mechatronery/scibee/SCIBee_Base/SCIBee_Base_Control_Board/SCIBee_Base_Control_Board_mount/RASPBERRY_PI_5_WITH_ACTIVE_COOLER.stl

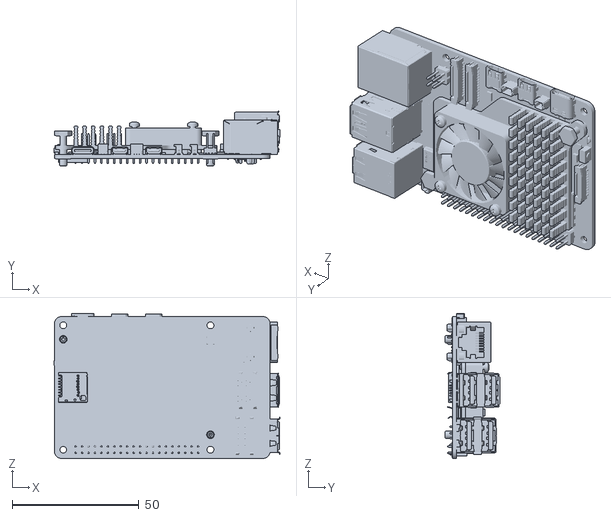
[picture p2: CAD file, 2026-10-22]
SCIBee_Base/SCIBee_Base_Control_Board/SCIBee_Base_Control_Board_mount/RASPBERRY_PI_5_WITH_ACTIVE_COOLER.stl
89.0 x 21.6 x 57.2
