mechatronery/scibee/SCIBee_Entrance/SCIBee_Entrance_Hardware/scibee_entrance_hardware.FCStd

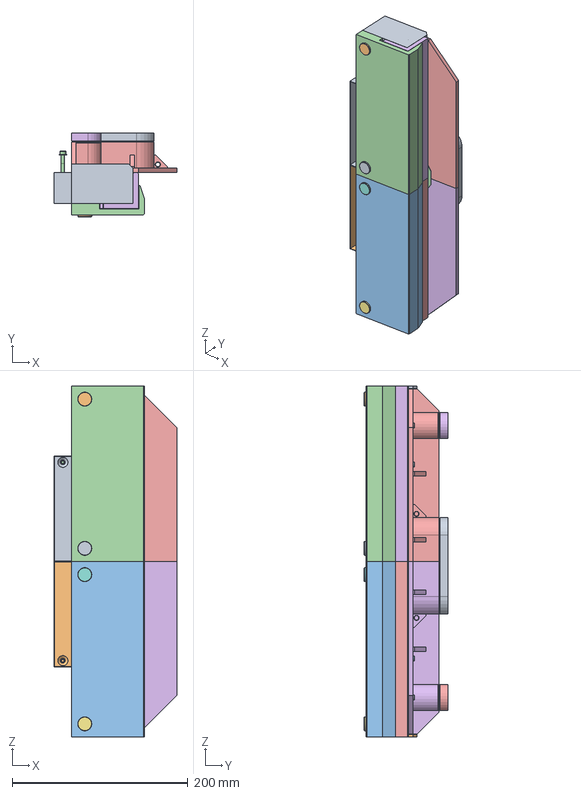
[picture p3: CAD file, 2026-10-22]
SCIBee_Entrance/SCIBee_Entrance_Hardware/scibee_entrance_hardware.FCStd
140.0 x 95.4 x 400.0 mm
Main_slice_0 x 2
Main_slice_1 x 2
Top_slice_0 x 2
Top_slice_1 x 2
Bot_slice_0 x 2
Bot_slice_1 x 2
Board
HSOP8
0805-NO
PANASONIC_D
0805-THM
Board001
HSOP009
0805-NO001
PANASONIC_D001
0805-THM001
M3x8-Screw340
M3x8-Screw342
M3x8-Screw343
M3-Washer311
M3x8-Screw344
M3-Washer312
M3x8-Screw345
M3-Washer313
M3x8-Screw339
M3-Washer309
M3-Nut
M3-Nut054
M3x8-Screw346
M3-Washer314
M3x8-Screw341
M3-Washer310
M3x8-Screw347
M3-Washer315
M3x8-Screw348
M3-Washer316
M3x8-Screw
M3-Washer
M3x8-Screw349
M3-Washer317
M3x8-Screw350
M3-Washer318
M3x8-Screw351
M3-Washer319
M3x8-Screw352
M3-Washer320
M3x8-Screw353
M3-Washer321
M3x8-Screw354
M3-Washer322
M3x8-Screw338
M3-Washer308
M3x8-Screw355
M3-Washer323
M3x8-Screw356
M3-Washer324
M3x16-Screw
M3x16-Screw005
M3-Nut055
M3-Nut056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
