mechatronery/scibee/SCIBee_Base/SCIBee_Base_Control_Board/SCIBee_Base_Control_Board_mount/models/MountingPlate_edge.stl

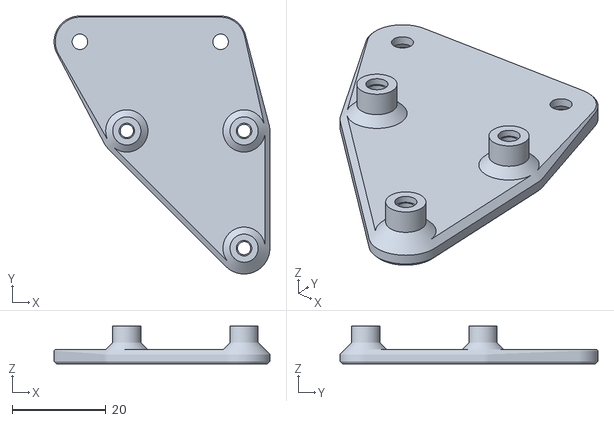
[picture p4: CAD file, 2026-10-22]
SCIBee_Base/SCIBee_Base_Control_Board/SCIBee_Base_Control_Board_mount/models/MountingPlate_edge.stl
46.0 x 55.0 x 8.00
