mechatronery/scibee/SCIBee_Base/SCIBee_Base_Control_Board/SCIBee_Base_Control_Board_mount/models/MountingPlate_powermeter.stl

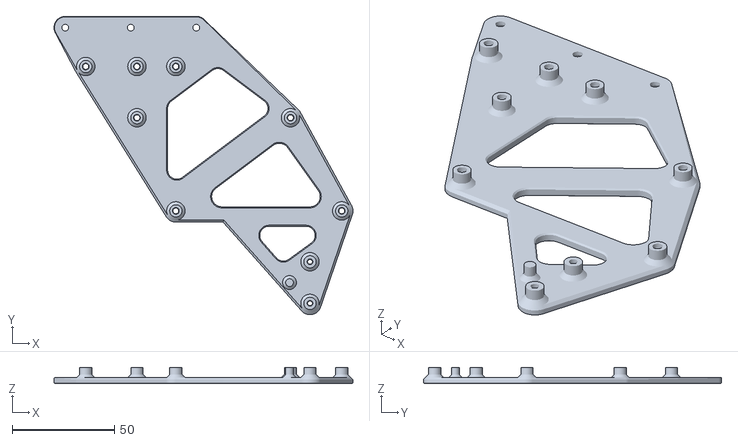
[picture p5: CAD file, 2026-10-22]
SCIBee_Base/SCIBee_Base_Control_Board/SCIBee_Base_Control_Board_mount/models/MountingPlate_powermeter.stl
146.0 x 145.7 x 8.00
