mechatronery/scibee/SCIBee_Base/SCIBee_Base_Control_Board/SCIBee_Base_Control_Board_mount/raspberry pi zero 2 w.stl

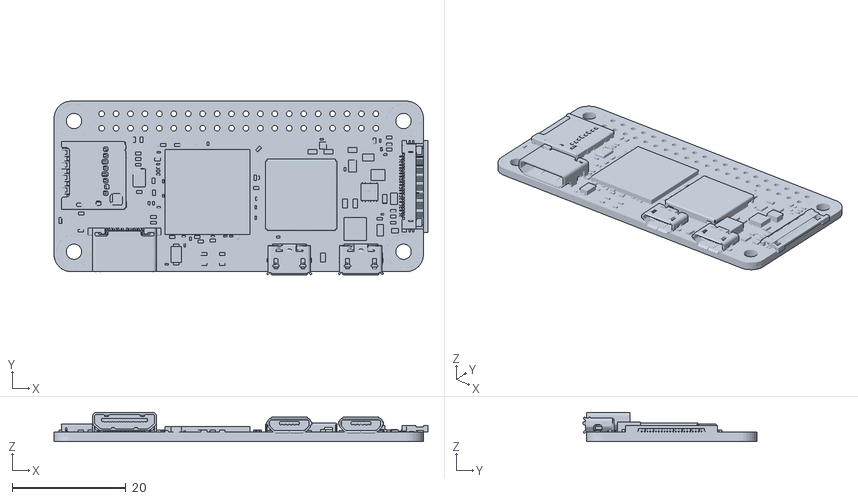
[picture p6: CAD file, 2026-10-22]
SCIBee_Base/SCIBee_Base_Control_Board/SCIBee_Base_Control_Board_mount/raspberry pi zero 2 w.stl
65.8 x 30.6 x 5.11
