mechatronery/scibee/SCIBee_Base/SCIBee_Base_Control_Board/SCIBee_Base_Control_Board_mount/models/Pump_adapter_tool.stl

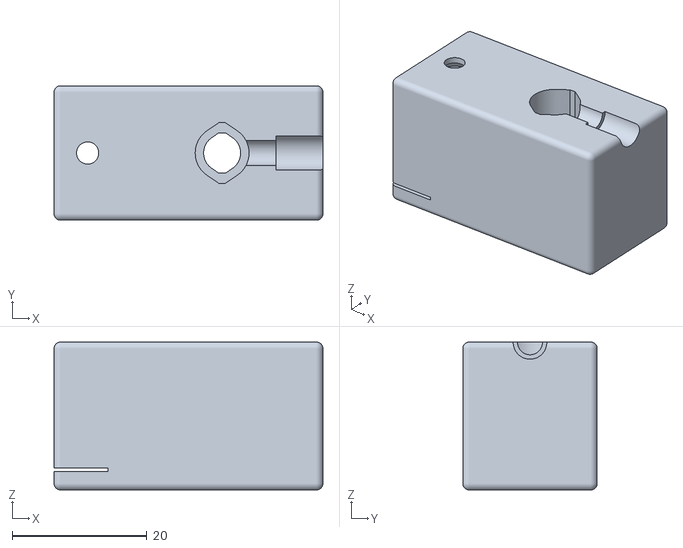
[picture p7: CAD file, 2026-10-22]
SCIBee_Base/SCIBee_Base_Control_Board/SCIBee_Base_Control_Board_mount/models/Pump_adapter_tool.stl
40.0 x 20.0 x 22.0
