mechatronery/scibee/SCIBee_Base/SCIBee_Base_Control_Board/SCIBee_Base_Control_Board_mount/models/MountingPlate_RPi_edge.stl

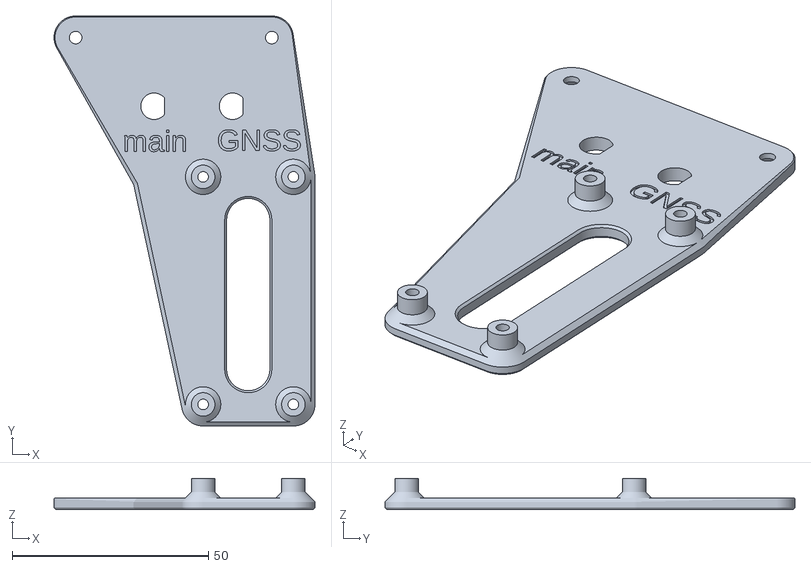
[picture p8: CAD file, 2026-10-22]
SCIBee_Base/SCIBee_Base_Control_Board/SCIBee_Base_Control_Board_mount/models/MountingPlate_RPi_edge.stl
66.5 x 104.5 x 8.00
