mechatronery/scibee/SCIBee_Base/SCIBee_Base_Control_Board/SCIBee_Base_Control_Board_mount/models/MountingPlate_RPi.stl

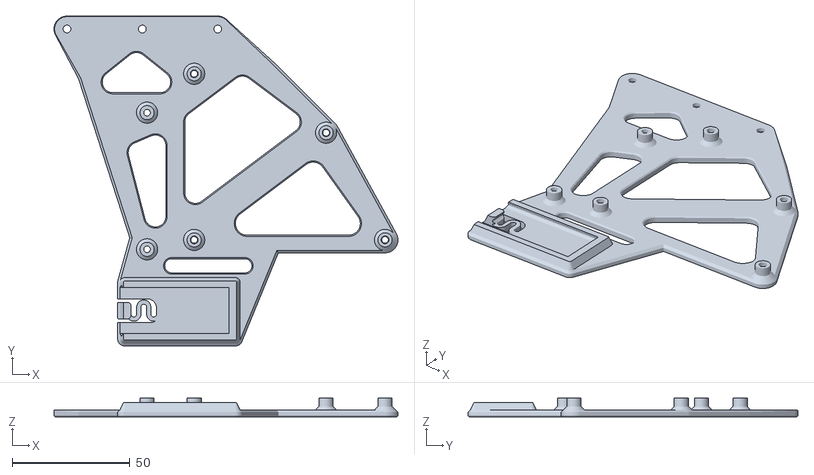
[picture p9: CAD file, 2026-10-22]
SCIBee_Base/SCIBee_Base_Control_Board/SCIBee_Base_Control_Board_mount/models/MountingPlate_RPi.stl
146.0 x 140.0 x 8.00
