mechatronery/scibee/SCIBee_Base/SCIBee_Base_Control_Board/SCIBee_Base_Control_Board_mount/models/PumpAdapter_MZB3004T04_top.stl

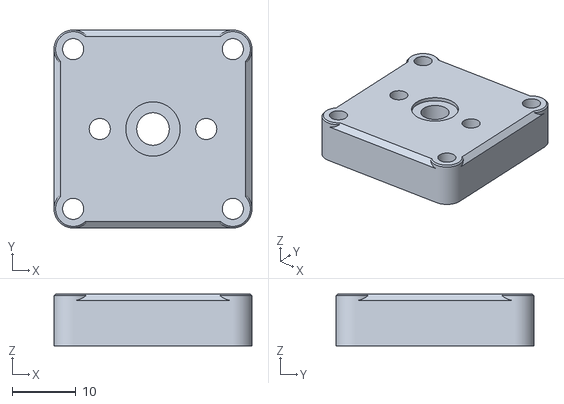
[picture p11: CAD file, 2026-10-22]
SCIBee_Base/SCIBee_Base_Control_Board/SCIBee_Base_Control_Board_mount/models/PumpAdapter_MZB3004T04_top.stl
31.0 x 31.0 x 8.10
