mechatronery/scibee/SCIBee_Base/SCIBee_Base_Control_Board/SCIBee_Base_Control_Board_mount/models/PumpAdapter_MZB3004T04_cap.stl

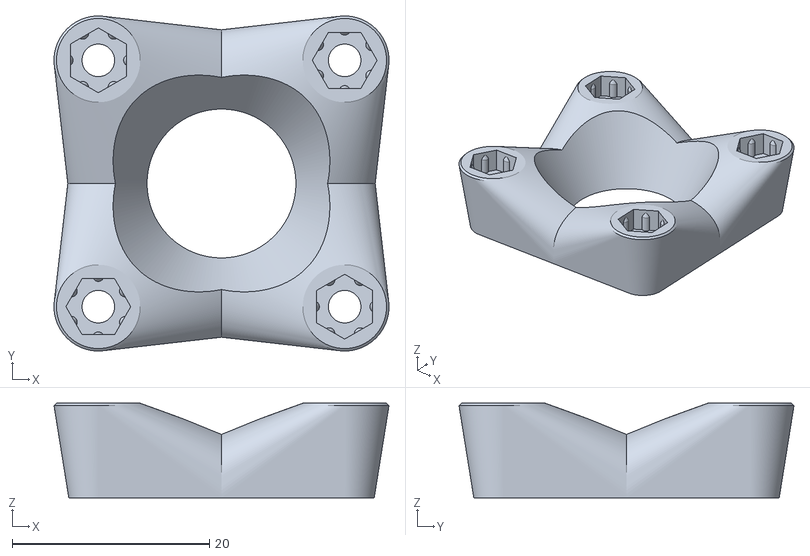
[picture p12: CAD file, 2026-10-22]
SCIBee_Base/SCIBee_Base_Control_Board/SCIBee_Base_Control_Board_mount/models/PumpAdapter_MZB3004T04_cap.stl
34.0 x 34.0 x 9.60
