mechatronery/scibee/SCIBee_Base/SCIBee_Base_Control_Board/SCIBee_Base_Control_Board_mount/models/PumpAdapter_MZB3004T04_2pump-connecting.stl

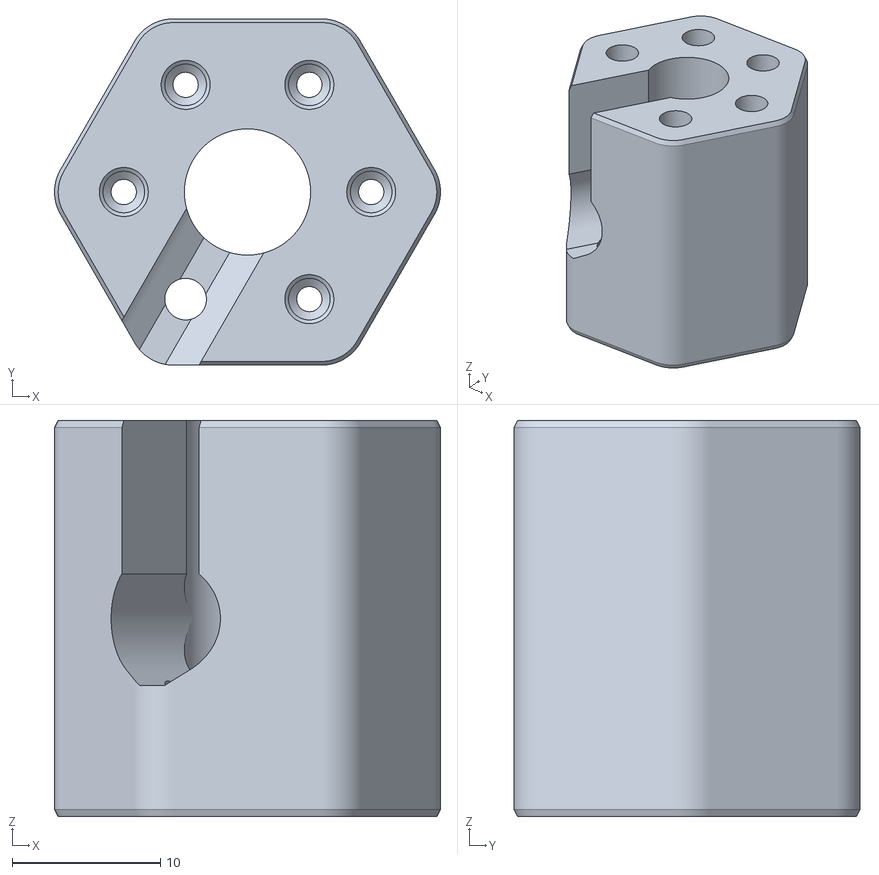
[picture p13: CAD file, 2026-10-22]
SCIBee_Base/SCIBee_Base_Control_Board/SCIBee_Base_Control_Board_mount/models/PumpAdapter_MZB3004T04_2pump-connecting.stl
26.0 x 23.3 x 26.7
