mechatronery/scibee/(list of files, cad)

Other CAD files:
SCIBee_Base/SCIBee_Base_Stand/scibee_base_stand.step
SCIBee_Base/SCIBee_Base_Control_Board/SCIBee_Base_Control_Board_mount/SCIBee_v1.11B.stl
SCIBee_Base/SCIBee_Base_Stand/scibee_base_stand.FCStd
