mechatronery/scibee/SCIBee_Base/SCIBee_Base_Stand/scibee_base_stand_parts.pdf

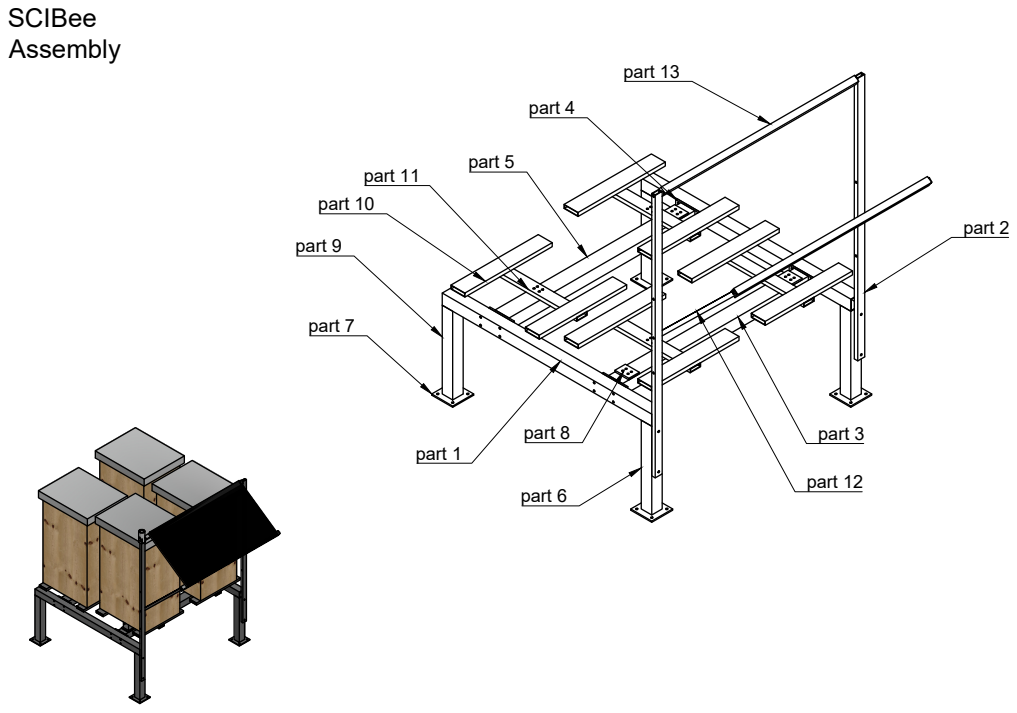
[picture p15: page 1]
part 1; part 2; part 3; part 4; part 5; part 6; part 7; part 8; part 9; part 10; part 11; part 12; part 13

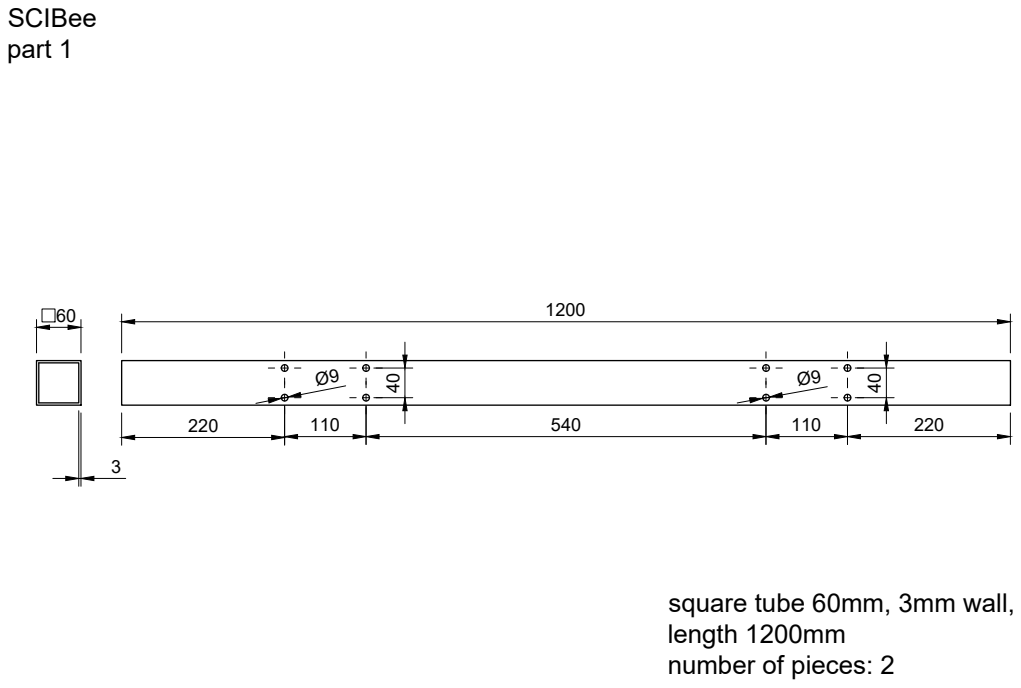
[picture p16: page 2]
part 1

square tube 60mm, 3mm wall,
length 1200mm
number of pieces: 2

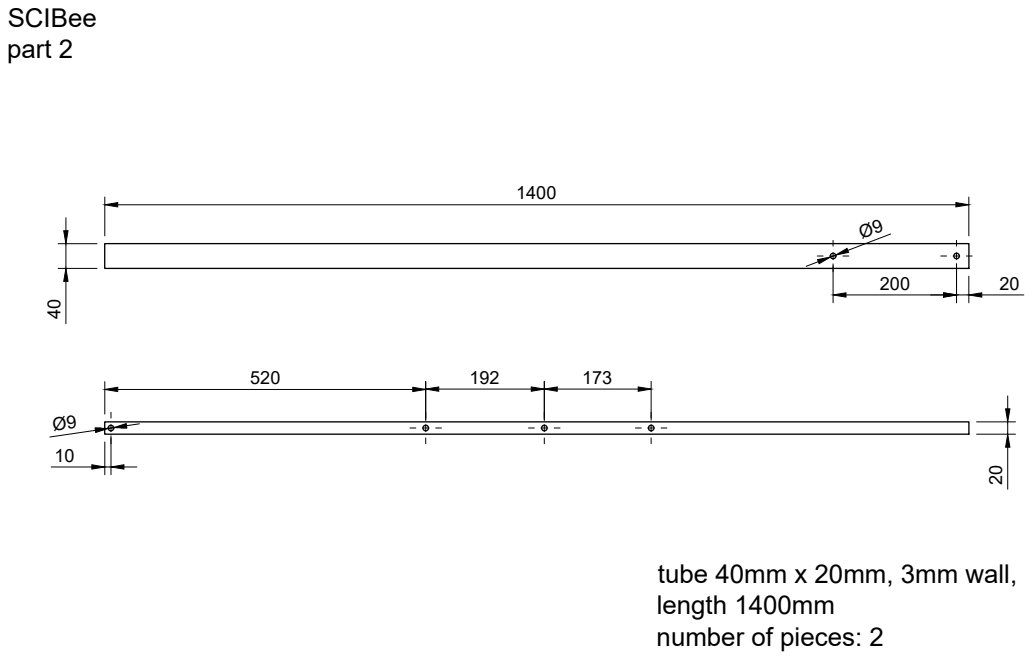
[picture p17: page 3]
part 2

tube 40mm x 20mm, 3mm wall,
length 1400mm
number of pieces: 2

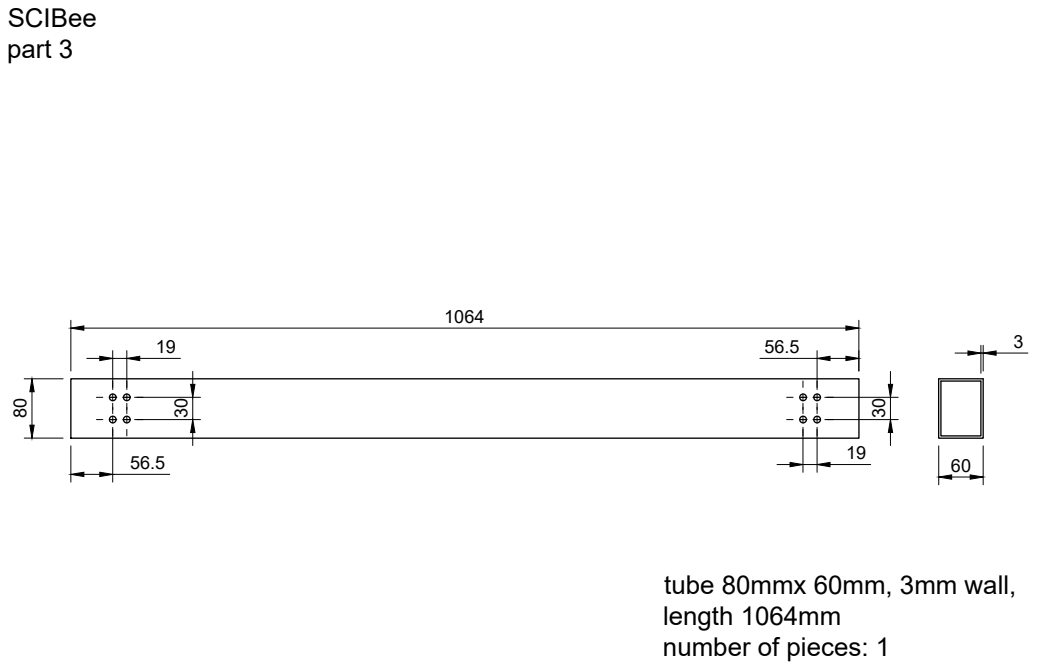
[picture p18: page 4]
part 3

tube 80mmx 60mm, 3mm wall,
length 1064mm
number of pieces: 1

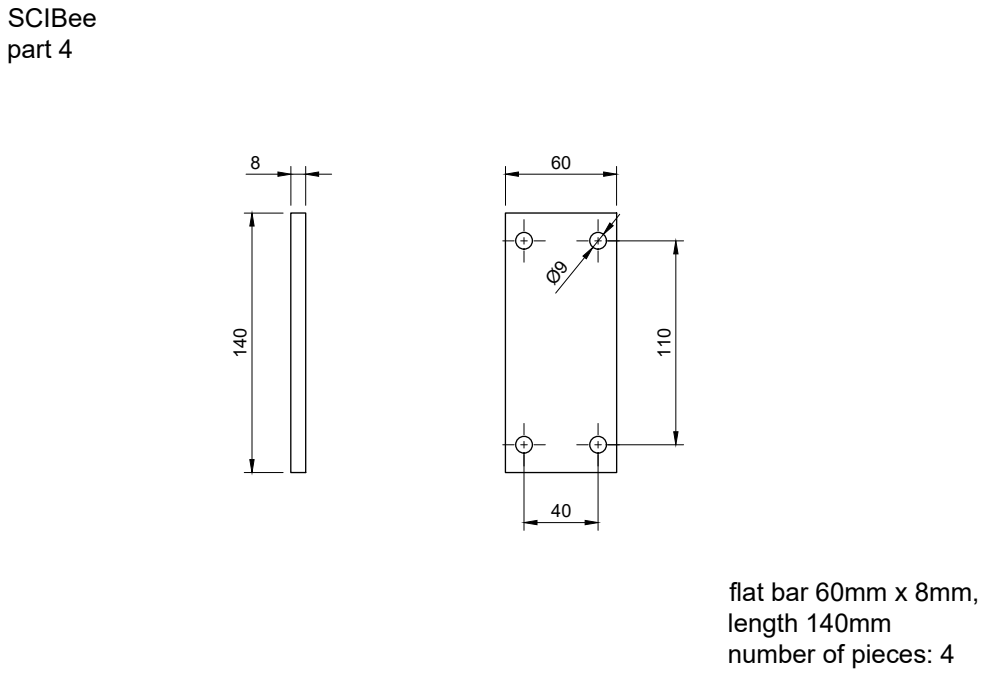
[picture p19: page 5]
flat bar 60mm x 8mm, length 140mm; part 4

number of pieces: 4 140

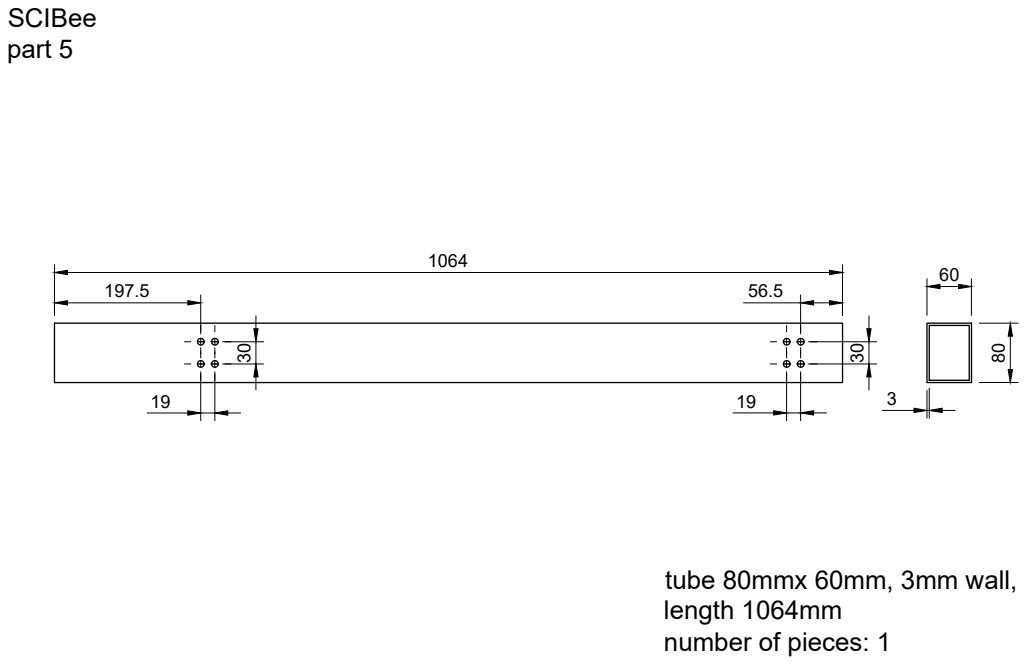
[picture p20: page 6]
part 5

tube 80mmx 60mm, 3mm wall,
length 1064mm
number of pieces: 1

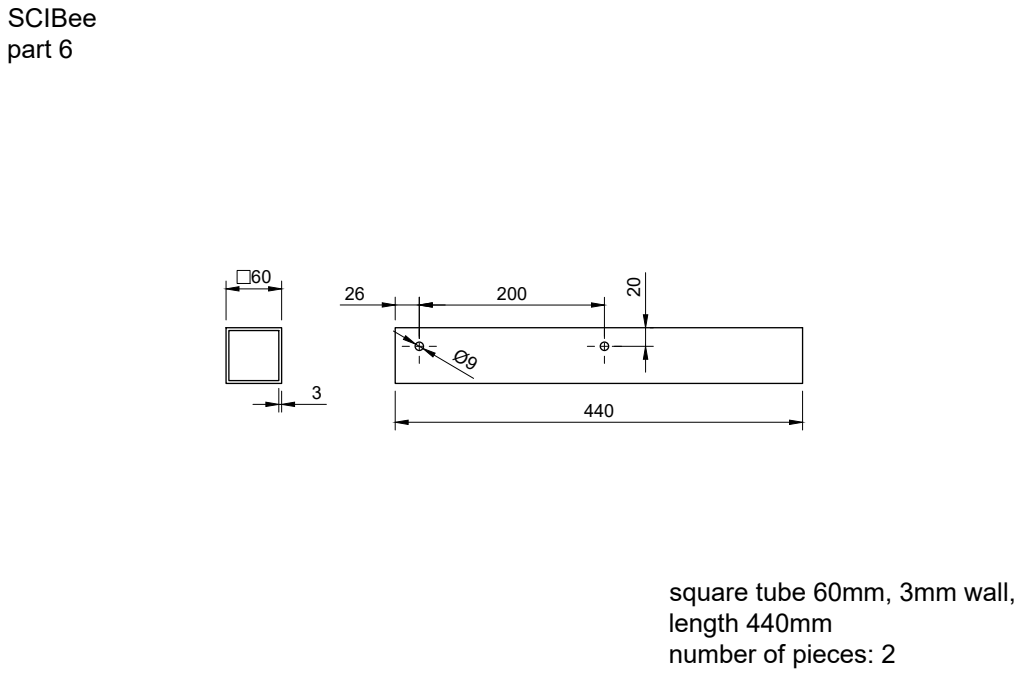
[picture p21: page 7]
part 6

square tube 60mm, 3mm wall,
length 440mm
number of pieces: 2

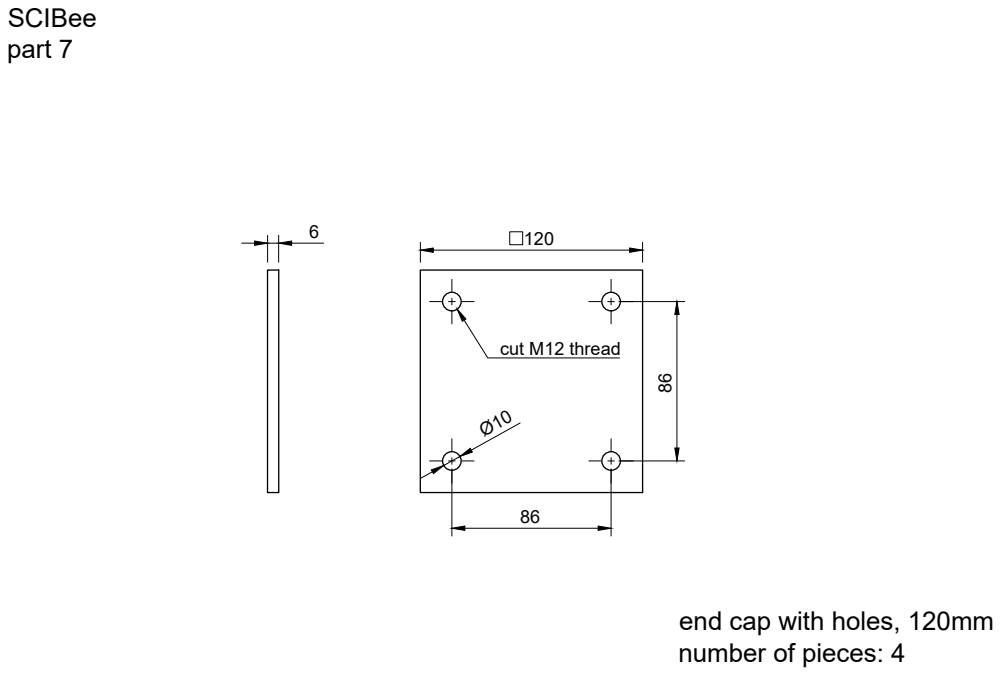
[picture p22: page 8]
cut M12 thread; part 7

end cap with holes, 120mm
number of pieces: 4

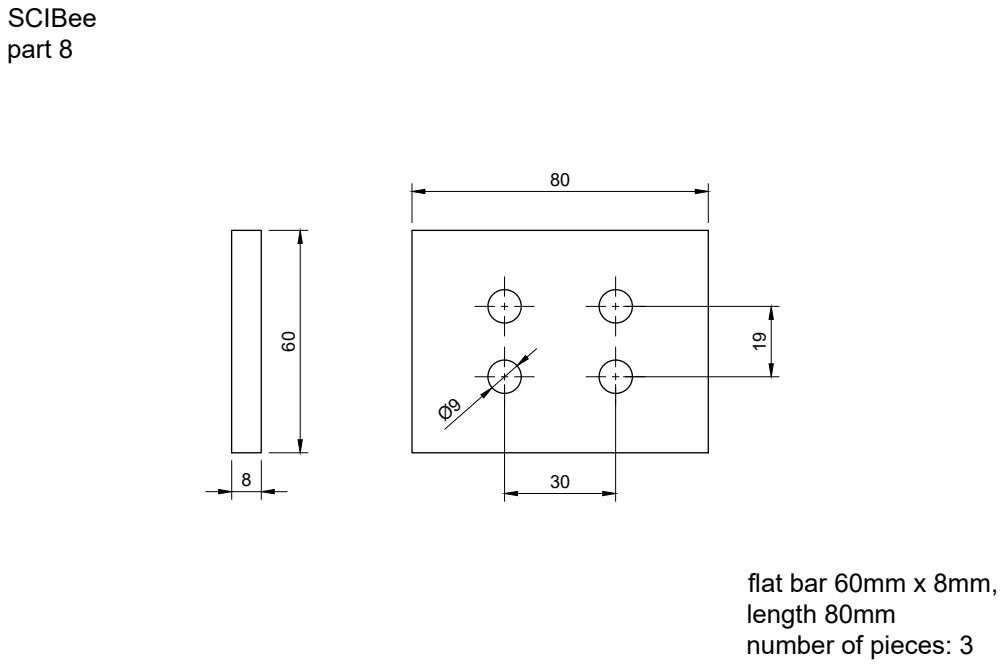
[picture p23: page 9]
flat bar 60mm x 8mm, length 80mm; part 8

number of pieces: 3 60

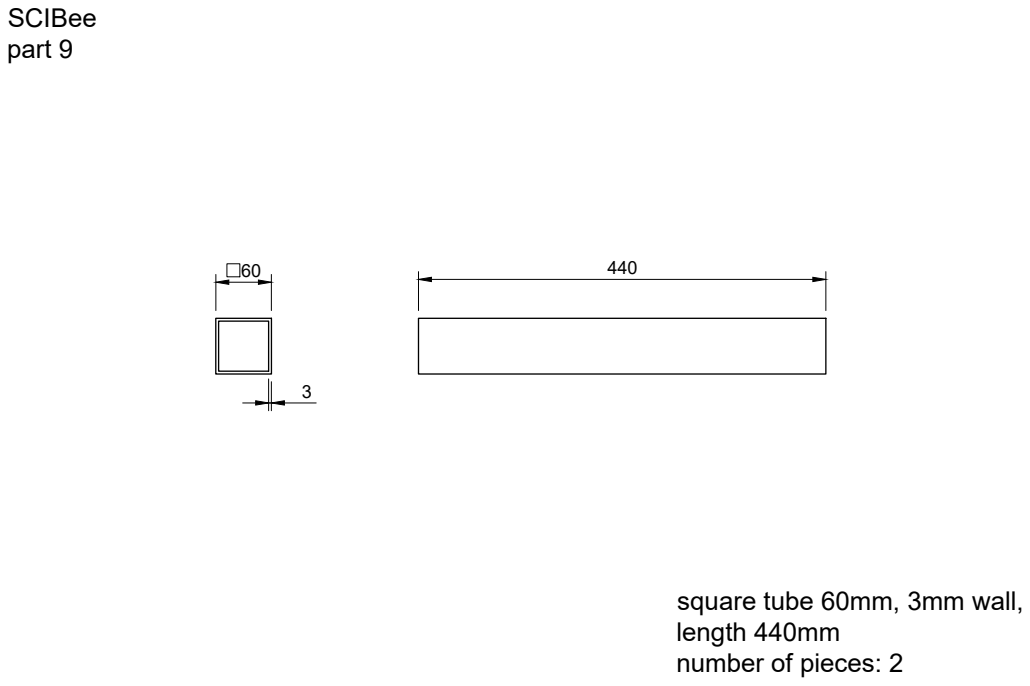
[picture p24: page 10]
part 9

square tube 60mm, 3mm wall,
length 440mm
number of pieces: 2

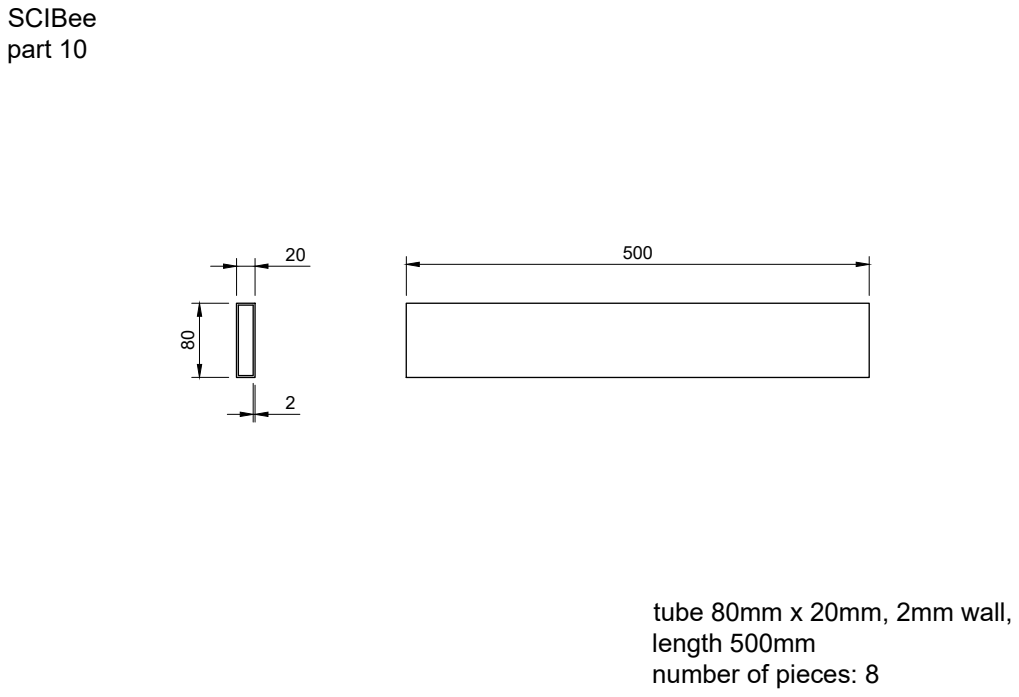
[picture p25: page 11]
tube 80mm x 20mm, 2mm wall, length 500mm; part 10

number of pieces: 8 80

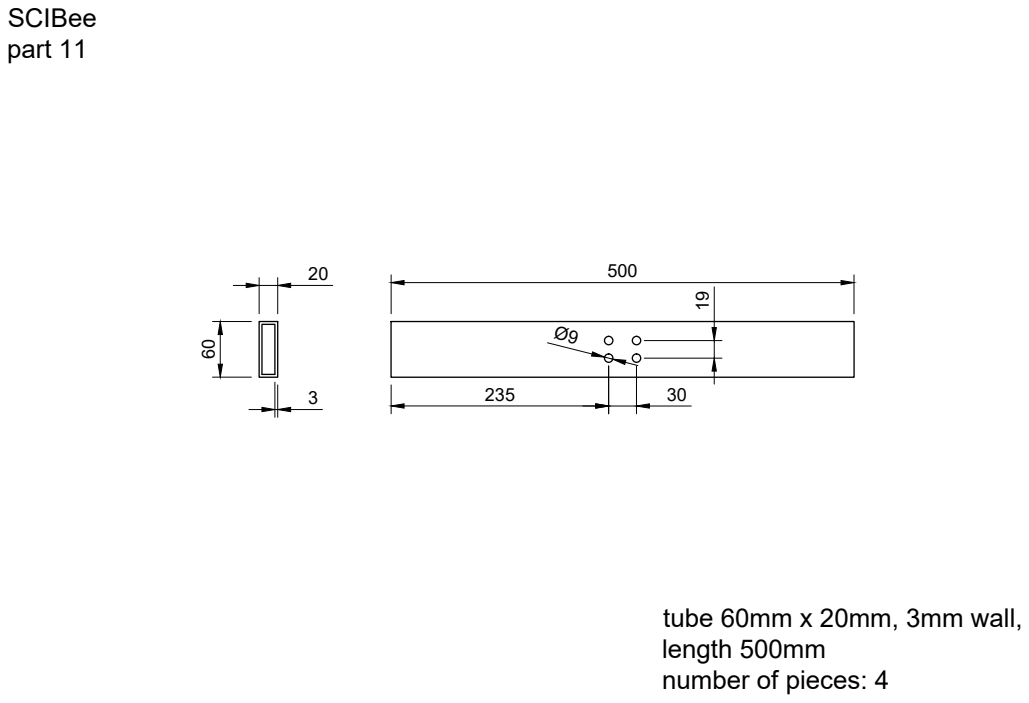
[picture p26: page 12]
tube 60mm x 20mm, 3mm wall, length 500mm; part 11

number of pieces: 4 60

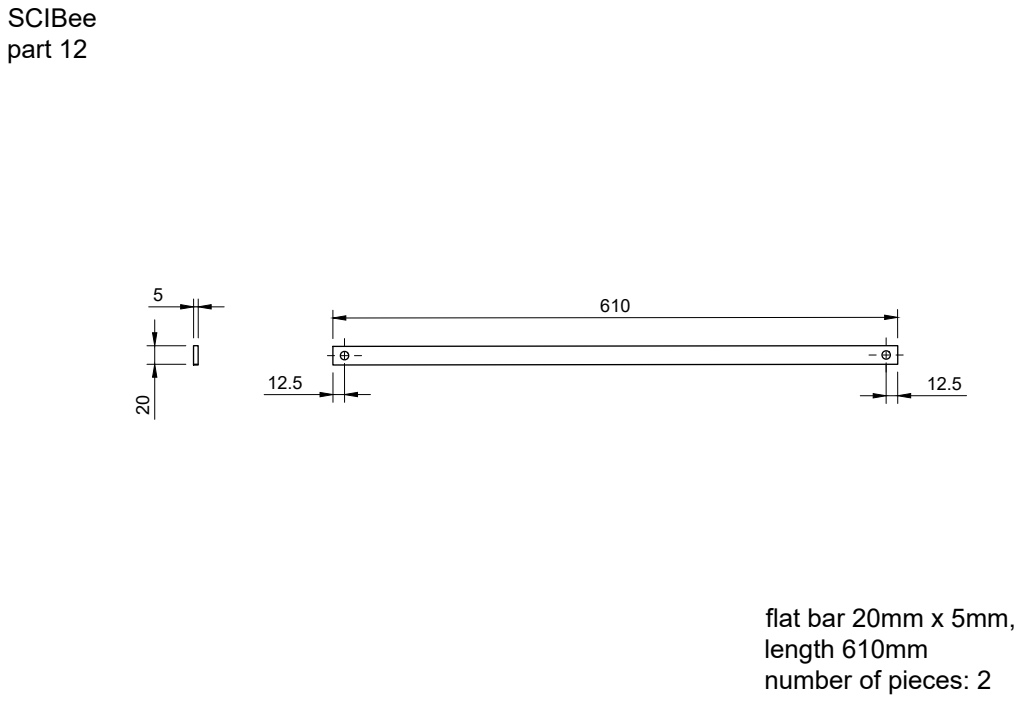
[picture p27: page 13]
part 12

flat bar 20mm x 5mm,
length 610mm
number of pieces: 2

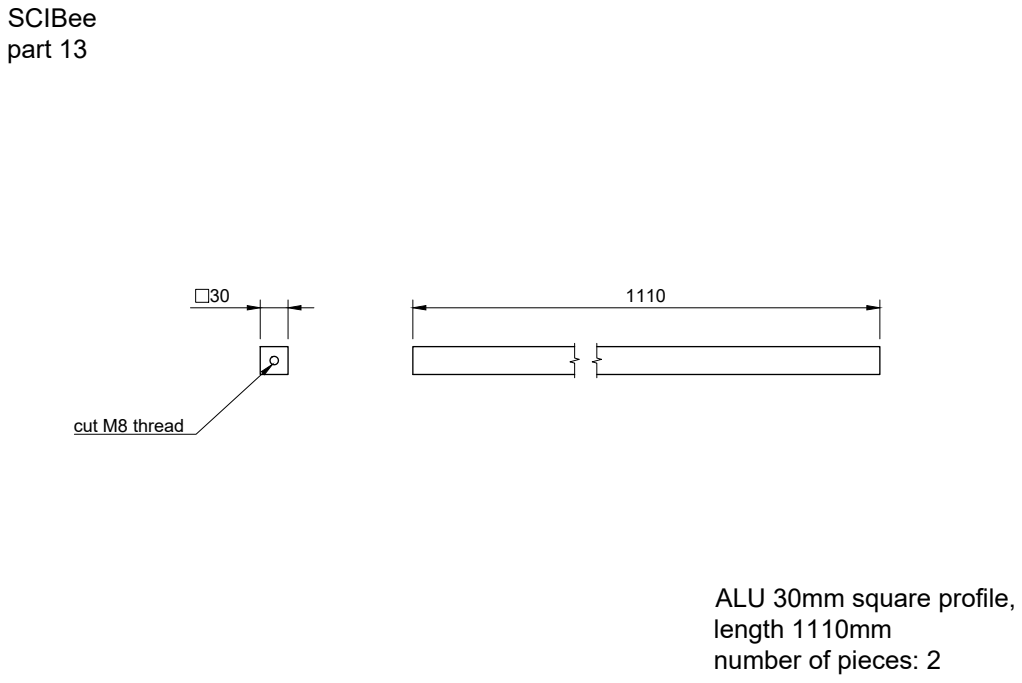
[picture p28: page 14]
cut M8 thread; part 13

ALU 30mm square profile,
length 1110mm
number of pieces: 2

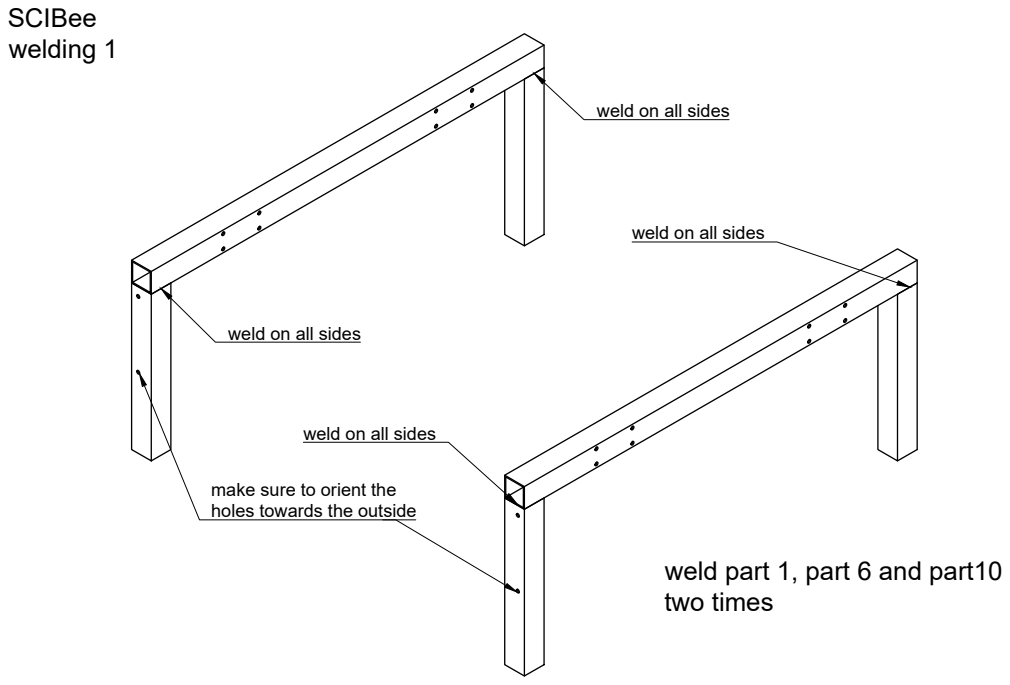
[picture p29: page 15]
welding 1

weld on all sides

make sure to orient the
holes towards the outside

weld part 1, part 6 and part10
two times

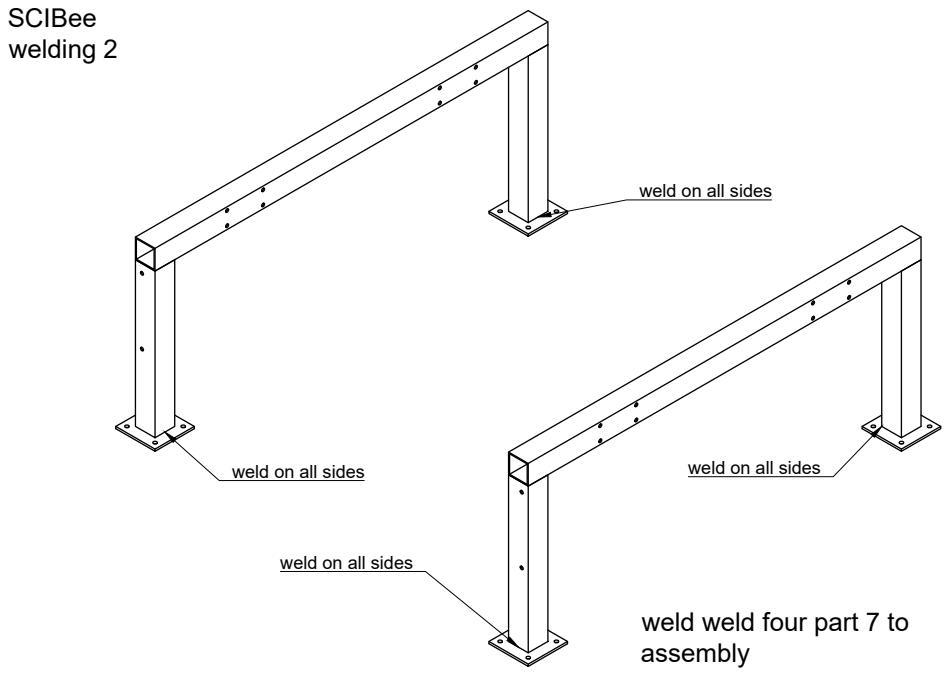
[picture p30: page 16]
welding 2

weld on all sides

weld weld four part 7 to
assembly

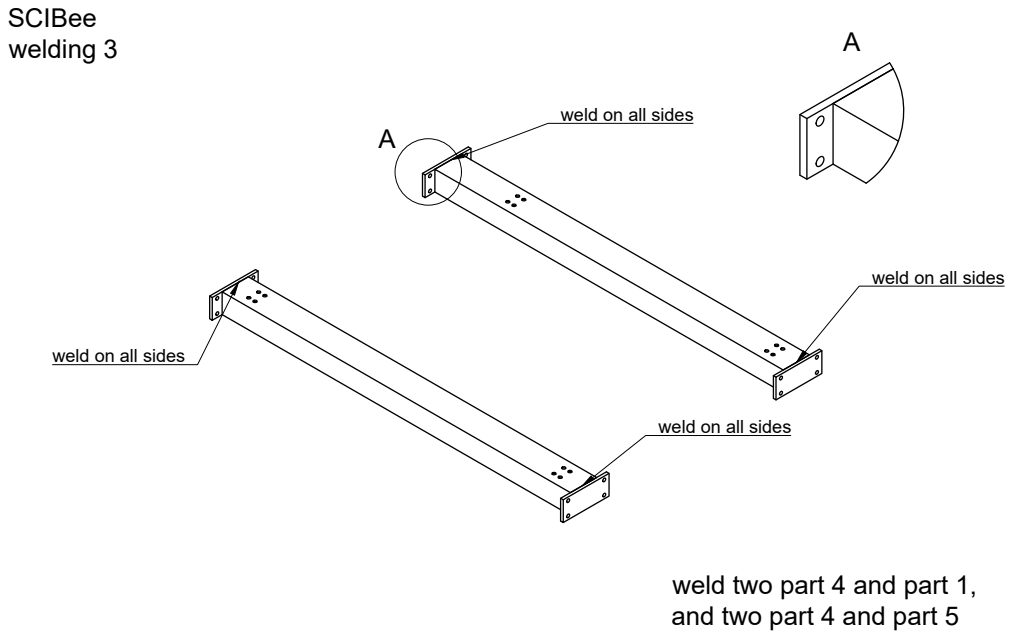
[picture p31: page 17]
welding 3

weld on all sides

weld two part 4 and part 1,
and two part 4 and part 5

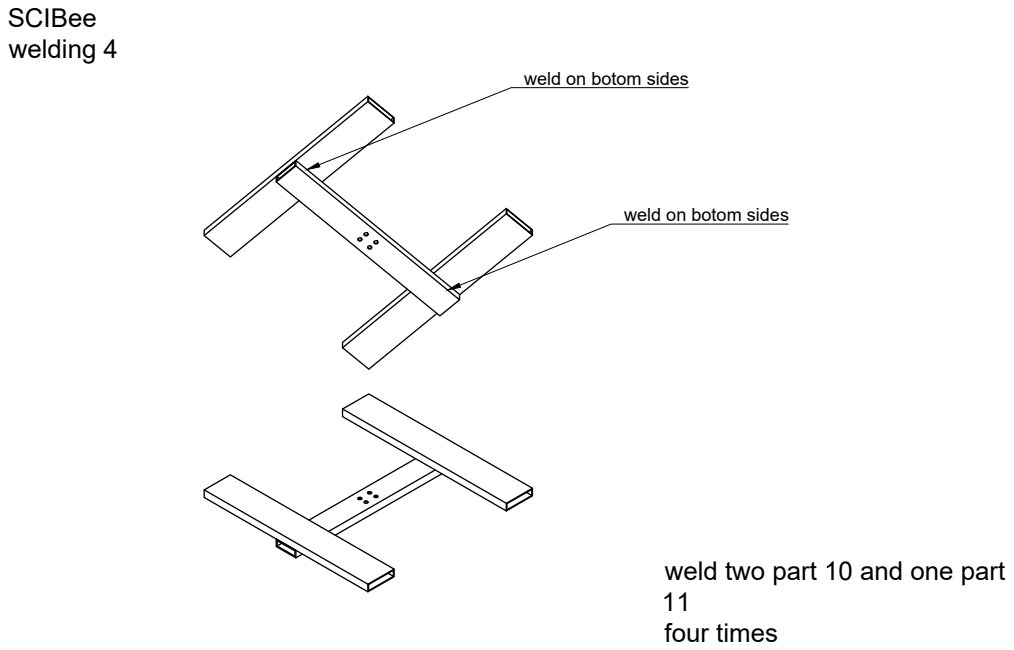
[picture p32: page 18]
welding 4

weld on botom sides

weld two part 10 and one part
four times
