mechatronery/scibee/SCIBee_Entrance/SCIBee_Entrance_Counter/SCIBee_Entrance_Counter_Corridor/SCIBee_Entrance_Counter_Corridor_PCB/scibee_entrance_counter_corridor/scibee_entrance_counter_corridor.kicad_pcb

## KiCad design SCIBee_Entrance/SCIBee_Entrance_Counter/SCIBee_Entrance_Counter_Corridor/SCIBee_Entrance_Counter_Corridor_PCB/scibee_entrance_counter_corridor/scibee_entrance_counter_corridor.kicad_pcb (2026-10-22)

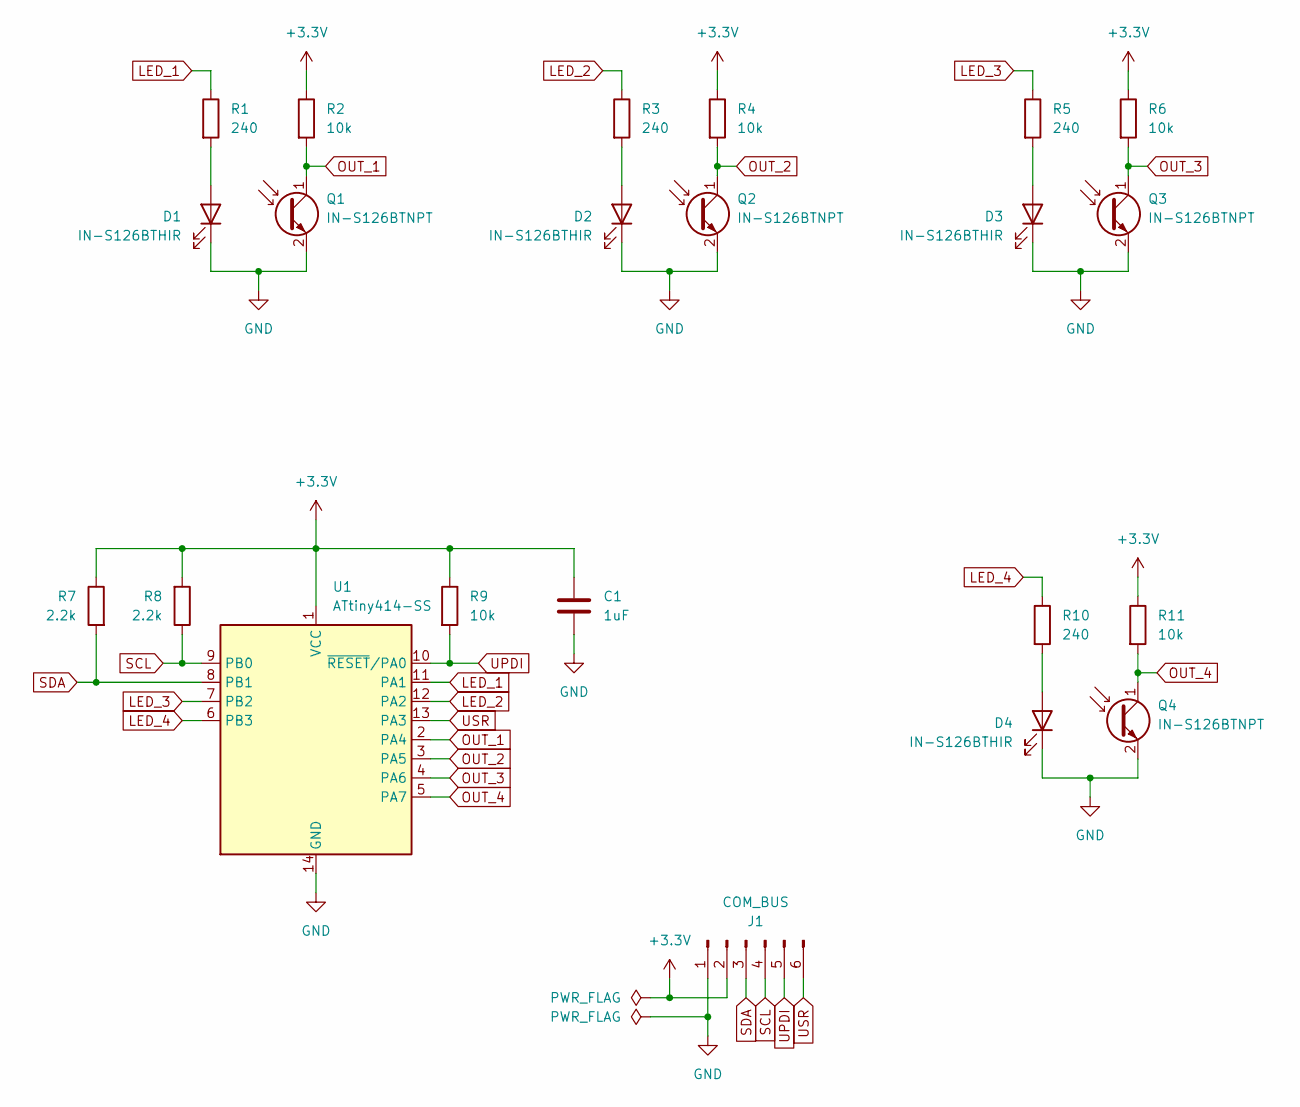
[picture p33: schematic scibee_entrance_counter_corridor.kicad_sch, SCIBee Entrance Counter Corridor]

Parts:
C1: 1uF; C_1206_3216Metric_Pad1.33x1.80mm_HandSolder
D1, D2, D3, D4: IN-S126BTHIR; LED_1206_3216Metric_Pad1.42x1.75mm_HandSolder
J1: COM_BUS; PinSocket_1x06_P2.54mm_Vertical
Q1, Q2, Q3, Q4: IN-S126BTNPT; LED_1206_3216Metric_Pad1.42x1.75mm_HandSolder
R1, R3, R5, R10: 240; R_1206_3216Metric_Pad1.30x1.75mm_HandSolder
R2, R4, R6, R9, R11: 10k; R_1206_3216Metric_Pad1.30x1.75mm_HandSolder
R7, R8: 2.2k; R_1206_3216Metric_Pad1.30x1.75mm_HandSolder
U1: ATtiny414-SS; SOIC-14_3.9x8.7mm_P1.27mm

Connections:
+3.3V: C1.2, J1.2, R2.1, R4.1, R6.1, R7.1, R8.2, R9.1, R11.1, U1.1 (VCC)
GND: C1.1, D1.1 (K), D2.1 (K), D3.1 (K), D4.1 (K), J1.1, Q1.2 (E), Q2.2 (E), Q3.2 (E), Q4.2 (E), U1.14 (GND)
LED_1: R1.1, U1.11 (PA1)
LED_2: R3.1, U1.12 (PA2)
LED_3: R5.1, U1.7 (PB2)
LED_4: R10.1, U1.6 (PB3)
unnamed: D1.2 (A), R1.2
unnamed: D2.2 (A), R3.2
unnamed: D3.2 (A), R5.2
unnamed: D4.2 (A), R10.2
OUT_1: Q1.1 (C), R2.2, U1.2 (PA4)
OUT_2: Q2.1 (C), R4.2, U1.3 (PA5)
OUT_3: Q3.1 (C), R6.2, U1.4 (PA6)
OUT_4: Q4.1 (C), R11.2, U1.5 (PA7)
SCL: J1.4, R8.1, U1.9 (PB0)
SDA: J1.3, R7.2, U1.8 (PB1)
UPDI: J1.5, R9.2, U1.10 (~RESET/PA0)
USR: J1.6, U1.13 (PA3)

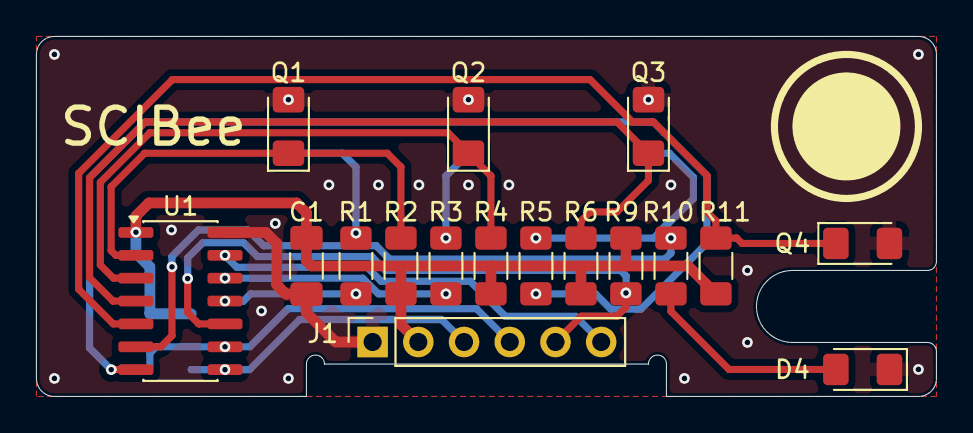
[picture p34: board scibee_entrance_counter_corridor.kicad_pcb from above]

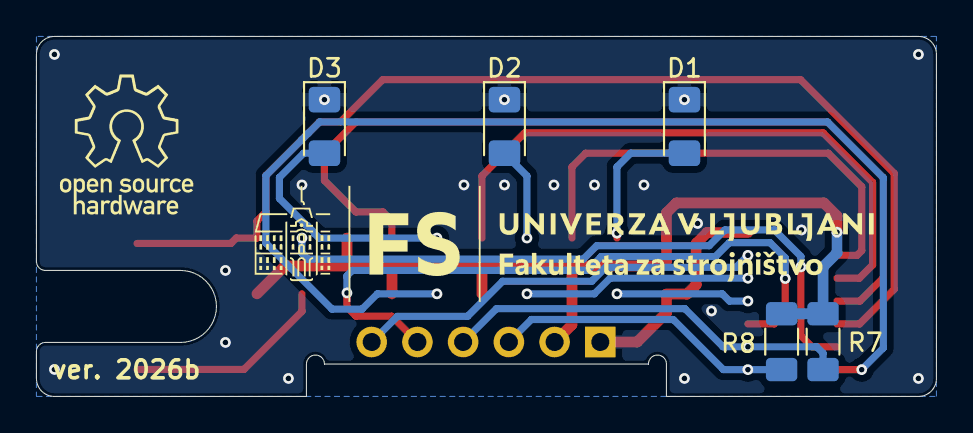
[picture p35: board scibee_entrance_counter_corridor.kicad_pcb from below]

Board: 2 copper layers, 50.0 x 20.0 mm, 22 parts (5 on the bottom side), 18 nets.
