mechatronery/scibee/SCIBee_Base/SCIBee_Base_Control_Board/SCIBee_Base_Control_Board_PCB/scibee_base_control_board/scibee_base_control_board.kicad_pcb

## KiCad design SCIBee_Base/SCIBee_Base_Control_Board/SCIBee_Base_Control_Board_PCB/scibee_base_control_board/scibee_base_control_board.kicad_pcb (2026-10-22)

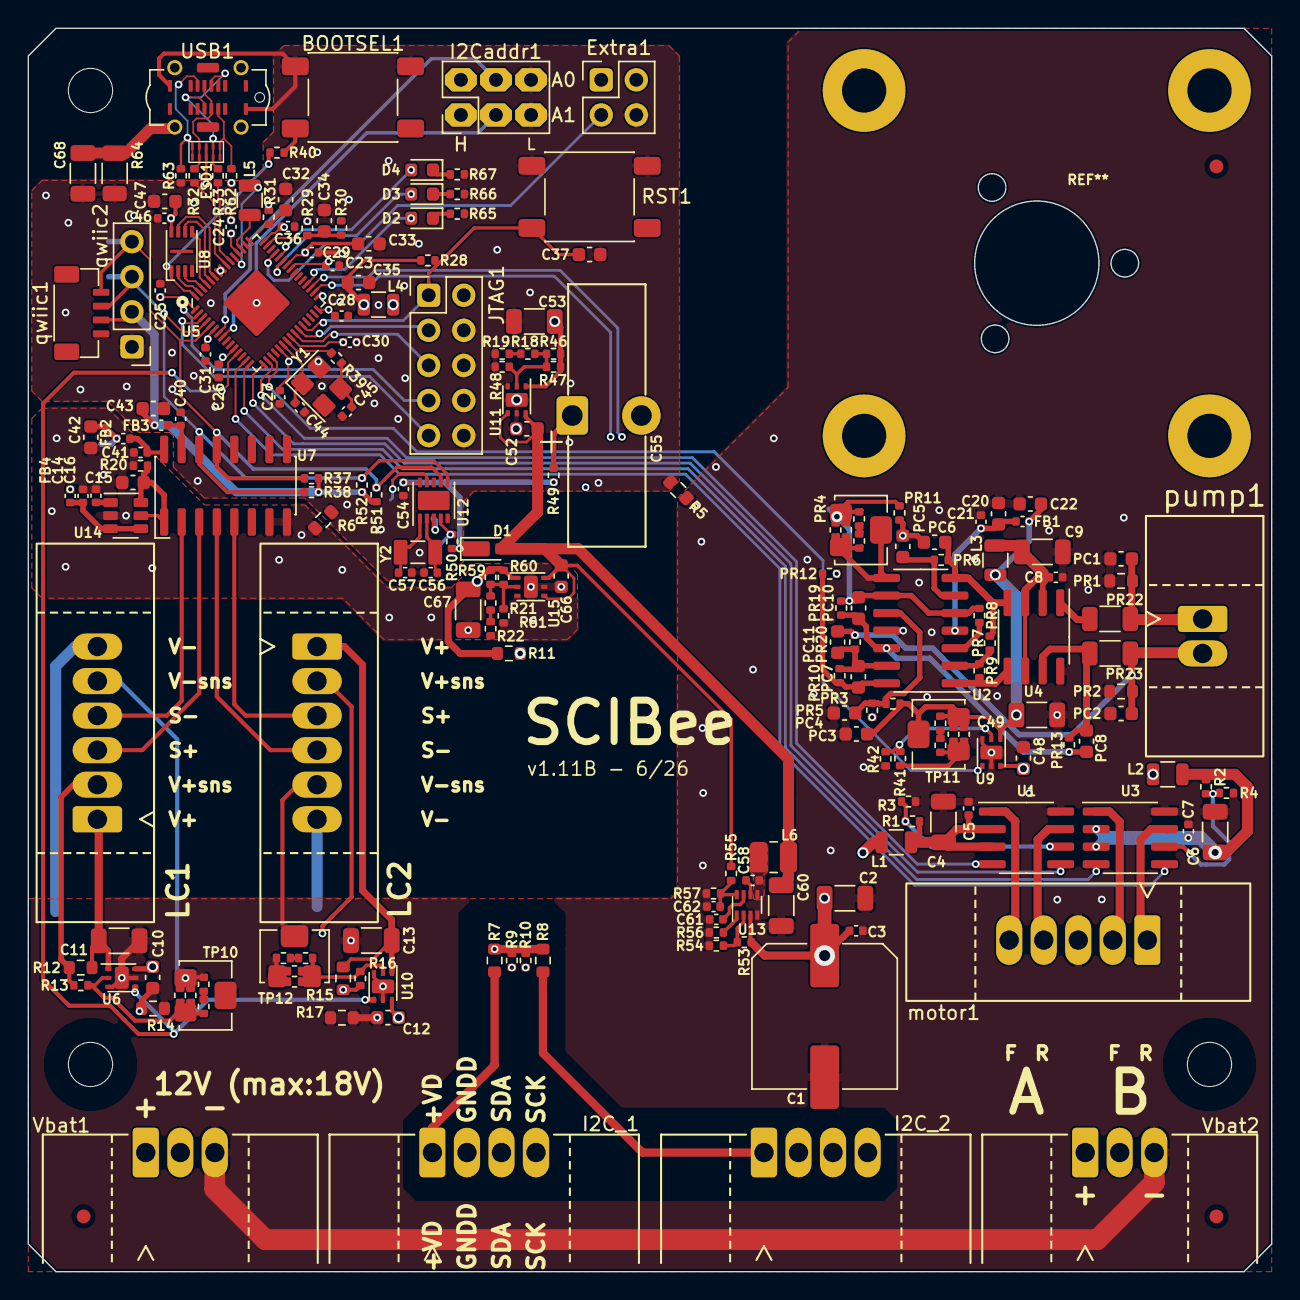
[picture p36: board scibee_base_control_board.kicad_pcb from above]

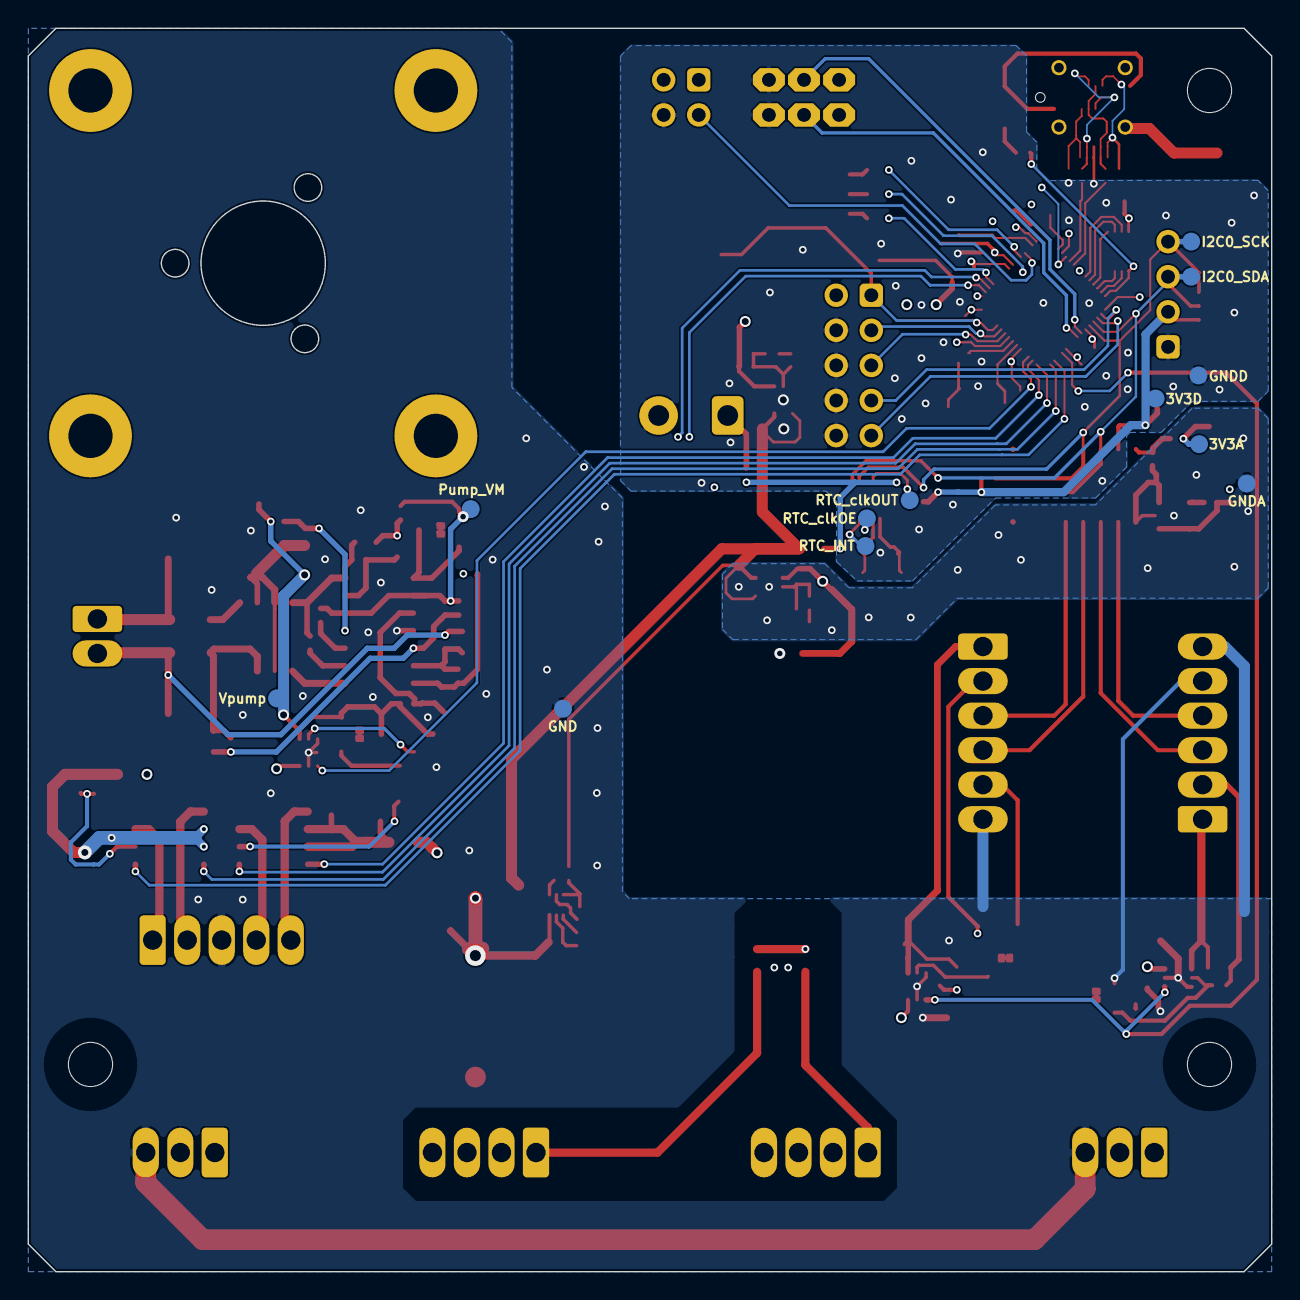
[picture p37: board scibee_base_control_board.kicad_pcb from below]

Board: 4 copper layers, 90.0 x 90.0 mm, 208 parts (12 on the bottom side), 118 nets.

Parts:
BOOTSEL1: SW_Momentary_NO; SW_PUSH_6mm_SMD
C1: Capacitor_pol; C_AlElec_SMD-10x10.2
C2, C4, C6, C9, C11, C13, C49, C53, C60, C67: 10uF; C_1206_(3216)
C3, C5, C7, C8, C14, C16, C21, C23, C24, C25, C26, C27, C28, C29, C30, C31, C36, C40, C41, C46, C54, C58, C61: 100nF; C_0402_(1005)
C10, C12, C15, C20, C22, C37, C42, C43, C48, C52, C66: 1uF; C_0603_(1608)
C32, C33, C34, C35, C47: 4u7F; C_0603_(1608)
C44, C45: 15pF; C_0402_(1005)
C55: 1F; C_Supercap_D18.7mm_P5.00mm_Vertical
C56, C57: -; C_0402_(1005)
C62: cap; C_0402_(1005)
C68: 2n2F; C_1206_(3216)
D1: RF05VAM1STR; D_DO-219AD_(microSMP)
D2: red; LED_0603_(1608)
D3: yellow; LED_0603_(1608)
D4: green; LED_0603_(1608)
ESD1: PUSB3FA2Z; DFN2510A-10
Extra1: 0.1" 2x2 header; Header_Pin_THT_Vertical_P2.54mm_2x02
FB1, FB2, FB3, FB4: FB600; L_0402_(1005)
FID1, FID2, FID3: Fiducial; Fiducial_1mm+2mm
I2C_1, I2C_2: TerminalBlock_2.5mm_Horizontal; TerminalBlock_1x04_P2.5mm_Horizontal_Screw
I2Caddr1: 0.1" 2x03 header; Header_Pin_THT_Vertical_P2.54mm_2x03
JTAG1: Conn_02x05; Header_Pin_THT_Vertical_P2.54mm_2x05
L1, L2, L3, L4, L5: 4u7H; L_0806_(2016)
L6: 22uH; L_1008_(2520)
LC1, LC2: TerminalBlock_2.5mm_Horizontal; TerminalBlock_1x06_P2.5mm_Vertical_Screw
M1, M3, M4: Mounting_hole; MountingHole_M3
PC1, PC2: 15pF; C_0603_(1608)
PC3, PC4: 1uF; C_0603_(1608)
PC5, PC6: 1nF; C_0603_(1608)
PC7, PC10: 10pF; C_0603_(1608)
PC8, PC11: 100pF; C_0603_(1608)
PR1, PR2: 1M; R_0603_(1608)
PR3, PR5, PR10, PR19: 470k; R_0402_(1005)
PR4: 10k; PVG5A
PR6: 68k; R_0402_(1005)
PR7, PR8, PR9: 10k; R_0402_(1005)
PR11: 390; R_0402_(1005)
PR12, PR13, PR20: 1k5; R_0402_(1005)
PR22, PR23: 10; R_1206_(3216)
R1, R2: 0; R_0402_(1005)
R3, R4, R30: -; R_0402_(1005)
R5, R6, R11: 0; R_0603_(1608)
R7, R8, R12, R14, R15, R17: -; R_0603_(1608)
R9, R10, R18, R21, R37, R38, R51, R52, R62, R63: 5k1; R_0402_(1005)
R13, R16, R41, R46, R47, R59, R60: 470k; R_0402_(1005)
R19, R22, R28, R42, R48, R61: 68k; R_0402_(1005)
R20, R50, R54, R56, R57: 10k; R_0402_(1005)
R29: 390R; R_0402_(1005)
R31, R32, R33: 27R; R_0402_(1005)
R39, R40: 1k5; R_0402_(1005)
R49, R65, R66, R67: 390; R_0402_(1005)
R53, R55: 39k; R_0402_(1005)
R64: 1M; R_1206_(3216)
RST1: SW_Momentary_NO; SW_PUSH_6mm_SMD
TP1: 3V3D; TestPoint
TP2: Pump_VM; TestPoint
TP3: 3V3A; TestPoint
TP4: GND; TestPoint
TP5: I2C0_SDA; TestPoint
TP6: I2C0_SCK; TestPoint
TP7: RTC_INT; TestPoint
TP8: RTC_clkOE; TestPoint
TP9: RTC_clkOUT; TestPoint
TP10, TP11, TP12: 500k; PVG5A
TP13: GNDA; TestPoint
TP14: GNDD; TestPoint
TP15: Vpump; TestPoint
U1, U3, U4: BD6231F-E2; SOIC-8_3.9x4.9mm_P1.27mm
U2: NCV274; SOIC-14_3.9x8.7mm_P1.27mm
U5: RP2350A; QFN-60-EP1_7x7mm_P0.4mm_EP3.4mm
U6, U9, U10, U11, U15: TPS7A2601; DFN-6-1EP_2x2mm_P0.65mm
U7: NAU7802SGI; SOIC-16_3.9x9.9mm_P1.27mm
U8: W25Q32RV; XSON-8-EP_2x3mm_P0.5mm_EP0.2x1.6mm
U12: PCF85063A; DFN-10_2.6x2.6_P0.5
U13: TPS62932; SOT-5X3-8
U14: MAX6070BAUT21+T; SOT-23-6
USB1: USB_C_USB2.0; USB_C_GCT_USB4220_Vertical
Vbat1, Vbat2: TerminalBlock_2.5mm_Horizontal; TerminalBlock_1x03_P2.5mm_Horizontal_Screw
Y1: 12MHz; Crystal_SMD_3225-4Pin_3.2x2.5mm
Y2: 32.768kHz; Crystal_SMD_TXC_9HT10
motor1: TerminalBlock_2.5mm_Horizontal; TerminalBlock_1x05_P2.5mm_Vertical_Screw
pump1: TerminalBlock_2.5mm_Vertical; TerminalBlock_1x02_P2.5mm_Vertical_Screw
qwiic1: SIO_SPARKFUN_qwiic; JST_SMD_Vertical_P1.00mm_BM04B
qwiic2: Conn_01x04; Header_Pin_THT_Vertical_P2.54mm_1x04

Connections:
+3.3VA: C42.1, C67.1, FB2.1, FB4.1, R11.2, R59.1, R60.1, TP3.1, U15.1 (Vout)
+3.3VD: C43.1, C53.1, Extra1.1, FB3.1, I2Caddr1.1, I2Caddr1.2, JTAG1.2, L4.2, R7.1, R8.1, R9.1, R10.1, R11.1, R37.1, R38.1, R46.1, R47.1, R51.1, R52.1, TP1.1, U11.1 (Vout), qwiic1.2 (3V3), qwiic2.2
+Vbat: C1.+, C2.1, C3.1, C10.1, C12.1, C48.1, L1.1, L2.1, R53.2, U6.6 (Vin), U9.6 (Vin), U10.6 (Vin), U13.3 (Vin), Vbat1.1, Vbat2.1
/+4V: C52.1, C60.1, C66.1, D1.A, L6.2, R55.1, U11.4 (EN), U11.6 (Vin), U15.4 (EN), U15.6 (Vin)
/H-bridge/VrefA: R1.2, R3.1, U1.6 (Vref)
/H-bridge/VrefB: R2.2, R4.1, U3.6 (Vref)
/I2C0_SCK: R37.2, R51.2, TP6.1, U5.5 (GPIO_3/SPI0_MOSI/UART0_RTS/I2C1_SCL/PWM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), U7.13 (SCK), U12.7 (SCL), qwiic1.4 (SCK), qwiic2.4
/I2C0_SDA: R38.2, R52.2, TP5.1, U5.4 (GPIO_2/SPI0_SCK/UART0_CTS/I2C1_SDA/PWM1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), U7.14 (SDA), U12.6 (SDA), qwiic1.3 (SDA), qwiic2.3
/I2C1_SCK: I2C_1.4, I2C_2.4, R10.2, U5.33 (GPIO_21/SPI0_CSn/UART1_RX/I2C0_SCL/PWM2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)
/I2C1_SDA: I2C_1.3, I2C_2.3, R9.2, U5.32 (GPIO_20/SPI0_MISO/UART1_TX/I2C0_SDA/PWM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)
/LC_enable: U5.12 (GPIO_8/SPI1_MISO/UART1_TX/I2C0_SDA/PWM4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), U6.4 (EN), U10.4 (EN)
/Load cell ADC I2C/Load cell Supply 1/+Vout: C11.1, LC1.1, R12.1, U6.1 (Vout)
/Load cell ADC I2C/Load cell Supply 1/+Vsns: LC1.2, R12.2, R13.1
/Load cell ADC I2C/Load cell Supply 2/+Vout: C13.1, LC2.1, R15.1, U10.1 (Vout)
/Load cell ADC I2C/Load cell Supply 2/+Vsns: LC2.2, R15.2, R16.1
/Load cell ADC I2C/Voltage reference/Aref: C15.1, R20.1, U7.1 (refP), U14.5 (OUTs), U14.6 (OUT)
/MOT_AF: U1.4 (Fin), U5.17 (GPIO_13/SPI1_CSn/UART0_RX/I2C0_SCL/PWM6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)
/MOT_AR: U1.5 (Rin), U5.16 (GPIO_12/SPI1_MISO/UART0_TX/I2C0_SDA/PWM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)
/MOT_BF: U3.4 (Fin), U5.15 (GPIO_11/SPI1_MOSI/UART1_RTS/I2C1_SCL/PW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)
/MOT_BR: U3.5 (Rin), U5.14 (GPIO_10/SPI1_SCK/UART1_CTS/I2C1_SDA/PWM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)
/PMP_enable: U5.18 (GPIO_14/SPI1_SCK/UART0_CTS/I2C1_SDA/PWM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), U9.4 (EN)
/Procesor/1V1: C29.1, C30.1, C31.1, C33.1, L5.2, U5.6 (DVDD), U5.23 (DVDD), U5.39 (DVDD), U5.50 (VREG_FB)
/Procesor/GPIO0: JTAG1.7, U5.2 (GPIO_0/SPI0_MISO/UART0_TX/I2C0_SDA/PWM0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)
/Procesor/GPIO1: JTAG1.9, U5.3 (GPIO_1/SPI0_CSn/UART0_RX/I2C0_SCL/PWM0_B)
/Procesor/GPIO4: I2Caddr1.4, U5.7 (GPIO_4/SPI0_MISO/UART1_TX/I2C0_SDA/PWM2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)
/Procesor/GPIO5: I2Caddr1.3, U5.8 (GPIO_5/SPI0_CSn/UART1_RX/I2C0_SCL/PWM2_B)
/Procesor/GPIO19: Extra1.2, U5.31 (GPIO_19/SPI0_MOSI/UART0_RTS/I2C1_SCL/PW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)
/Procesor/GPIO22: D2.A, U5.34 (GPIO_22/SPI0_SCK/UART1_CTS/I2C1_SDA/PWM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)
/Procesor/GPIO26/ADC0: D3.A, U5.40 (GPIO_26/ADC0/SPI1_SCK/UART1_CTS/I2C1_SD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)
/Procesor/GPIO27/ADC1: D4.A, U5.41 (GPIO_27/ADC1/SPI1_MOSI/UART1_RTS/I2C1_S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)
/Procesor/GPIO28/ADC2: Extra1.3, U5.42 (GPIO_28/ADC2/SPI1_RX/UART0_TX/I2C0_SDA/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)
/Procesor/QSPI_SCLK: U5.56 (QSPI_SCLK), U8.6 (CLK)
/Procesor/QSPI_SD0: U5.57 (QSPI_SD0), U8.5 (MOSI/IO0)
/Procesor/QSPI_SD1: U5.59 (QSPI_SD1), U8.2 (MISO/IO1)
/Procesor/QSPI_SD2: U5.58 (QSPI_SD2), U8.3 (~WP/IO2)
/Procesor/QSPI_SD3: U5.55 (QSPI_SD3), U8.7 (~HOLD/~RST/IO3)
/Procesor/QSPI_SS: R40.1, U5.60 (QSPI_CSn), U8.1 (~CS)
/Procesor/RP_CLK/Xin: C44.1, U5.21 (XIN), Y1.1
/Procesor/RP_CLK/Xout: R39.2, U5.22 (XOUT)
/Procesor/RP_FLASH/3V3: C23.1, C24.1, C25.1, C26.1, C27.1, C28.1, C35.1, C36.1, C46.1, C47.1, L4.1, R28.1, R29.2, R31.1, U5.1 (IOVDD), U5.11 (IOVDD), U5.20 (IOVDD), U5.30 (IOVDD), U5.38 (IOVDD), U5.45 (IOVDD), U5.49 (VREG_Vin), U5.53 (USB_VDD), U5.54 (QSPI_IOVDD), U8.8 (VCC)
/Procesor/RUN: C37.1, JTAG1.1, R28.2, RST1.COM, U5.26 (RUN)
/Procesor/SC: JTAG1.5, U5.24 (SWCLK)
/Procesor/SD: JTAG1.3, U5.25 (SWDIO)
/Procesor/USB_N: ESD1.2 (K2), ESD1.9 (K2), R33.1, USB1.A7 (D-), USB1.B7 (D-)
/Procesor/USB_P: ESD1.4 (K3), ESD1.7 (K3), R32.1, USB1.A6 (D+), USB1.B6 (D+)
/Pump driver/Piezo pump regulated suply/+Vout: C22.1, C49.1, FB1.1, L3.1, PC3.1, PR3.1, TP11.C, TP11.S, TP15.1, U9.1 (Vout)
/Pump driver/Vm: PC10.1, PR4.CC, PR8.2, PR11.2, PR19.1, TP2.1, U2.5 (+), U2.9 (-)
/RTC/clkOE: TP8.1, U12.3 (clkOE)
/RTC/clkOUT: TP9.1, U12.9 (clkOUT)
/RTC/~INT: R50.2, TP7.1, U12.4 (~INT)
GND: C1.-, C2.2, C3.2, C4.2, C5.2, C6.2, C7.2, C8.2, C9.2, C10.2, C11.2, C12.2, C13.2, C20.2, C21.2, C22.2, C48.2, C49.2, C60.2, C61.2, C62.2, LC1.5, LC1.6, LC2.5, LC2.6, PC1.2, PC2.2, PC3.2, PC4.2, PR1.1, PR2.1, PR5.2, R3.2, R4.2, R5.2, R14.1, R14.2, R17.1, R17.2, R42.2, R54.2, R56.2, R57.2, TP4.1, TP10.CC, TP10.S, TP12.CC, TP12.S, U1.8 (GND), U2.11 (V-), U3.8 (GND), U4.8 (GND), U6.0 (GND), U6.3 (PG), U6.5 (GND), U9.0 (GND), U9.3 (PG), U9.5 (GND), U10.0 (GND), U10.3 (PG), U10.5 (GND), U13.4 (GND), Vbat1.3, Vbat2.3, motor1.3
GNDA: C14.2, C15.2, C16.2, C41.2, C42.2, C66.2, C67.2, R6.1, R20.2, R22.2, R61.2, TP13.1, U7.7 (refN), U7.8 (AVss), U14.2 (GND), U15.0 (GND), U15.3 (PG), U15.5 (GND)
GNDD: BOOTSEL1.NO, C23.2, C24.2, C25.2, C26.2, C27.2, C28.2, C29.2, C30.2, C31.2, C32.2, C33.2, C34.2, C35.2, C36.2, C37.2, C40.2, C43.2, C44.2, C45.2, C46.2, C47.2, C52.2, C53.2, C54.2, C55.-, C56.2, C57.2, C68.2, ESD1.3 (GND), ESD1.8 (GND), Extra1.4, I2C_1.2, I2C_2.2, I2Caddr1.5, I2Caddr1.6, JTAG1.4, JTAG1.6, JTAG1.8, JTAG1.10, R5.1, R6.2, R19.2, R48.2, R62.2, R63.2, R64.2, R65.2, R66.2, R67.2, RST1.NO, TP14.1, U5.0 (GND), U5.47 (VREG_PGND), U7.9 (DVss), U8.4 (GND), U11.0 (GND), U11.3 (PG), U11.5 (GND), U12.5 (Vss), USB1.A1 (GND), USB1.B1 (GND), Y1.2, Y1.4, qwiic1.1 (GND), qwiic2.1
unnamed: BOOTSEL1.COM, R40.2
unnamed: C4.1, C5.1, L1.2, R1.1, U1.2 (Vcc), U1.3 (Vcc)
unnamed: C6.1, C7.1, L2.2, R2.1, U3.2 (Vcc), U3.3 (Vcc)
unnamed: C45.1, R39.1, Y1.3
unnamed: C55.+, R49.1
unnamed: D2.K, R65.1
unnamed: D3.K, R66.1
unnamed: D4.K, R67.1
unnamed: I2C_1.1, R7.2
unnamed: I2C_2.1, R8.2
unnamed: LC1.3, U7.3 (CH1+)
unnamed: LC1.4, U7.2 (CH1-)
unnamed: LC2.3, U7.5 (CH2+)
unnamed: LC2.4, U7.4 (CH2-)
unnamed: PC5.2, PC6.1, PR11.1, PR12.1
unnamed: PC7.2, PR10.1, PR12.2, U2.14
unnamed: PR4.C, PR4.S, U2.8
unnamed: R18.2, R19.1
unnamed: R21.2, R22.1
unnamed: R41.1, TP11.CC
unnamed: U1.1 (OUT1), motor1.5
unnamed: U1.7 (OUT2), motor1.4
unnamed: PR8.1, U2.3 (+)
unnamed: PR7.2, PR9.2, U2.2 (-)
unnamed: PC5.1, PR6.2, U2.6 (-)
unnamed: PC4.1, PR3.2, PR5.1, U2.10 (+)
unnamed: PC8.1, PC10.2, PR13.1, PR19.2, U2.12 (+)
unnamed: PC7.1, PC11.1, PR10.2, PR20.1, U2.13 (-)
unnamed: C20.1, C21.1, FB1.2, U2.4 (V+)
unnamed: U3.1 (OUT1), motor1.2
unnamed: U3.7 (OUT2), motor1.1
unnamed: PC6.2, PR6.1, PR7.1, U2.7, U4.4 (Fin)
unnamed: PR22.2, U4.1 (OUT1)
unnamed: PC8.2, PR13.2, PR23.2, U4.7 (OUT2)
unnamed: PR9.1, U2.1, U4.5 (Rin)
unnamed: C8.1, C9.1, L3.2, U4.2 (Vcc), U4.3 (Vcc), U4.6 (Vref)
unnamed: C34.1, R29.1, R30.2, U5.44 (AVDD)
unnamed: R33.2, U5.51 (USB_DM)
unnamed: R32.2, U5.52 (USB_DP)
unnamed: C32.1, R31.2, U5.46 (VREG_AVdd)
unnamed: L5.1, U5.48 (VREG_LX)
unnamed: R13.2, TP10.C, U6.2 (fb)
unnamed: C41.1, FB2.2, U7.16 (AVdd)
unnamed: C40.1, FB3.2, U7.15 (DVdd)
unnamed: R41.2, R42.1, U9.2 (fb)
unnamed: R16.2, TP12.C, U10.2 (fb)
unnamed: R18.1, R46.2, R47.2, R48.1, U11.2 (fb)
unnamed: C57.1, U12.1 (OSCI), Y2.2
unnamed: C56.1, U12.2 (OSCO), Y2.1
unnamed: C54.1, D1.K, R49.2, R50.1, U12.10 (Vdd)
unnamed: R53.1, R54.1, U13.2 (EN)
unnamed: C62.1, R55.2, R57.1, U13.8 (FB)
unnamed: C61.1, U13.7 (SS)
unnamed: C58.2, L6.1, U13.5 (SW)
unnamed: C58.1, U13.6 (bst)
unnamed: R56.1, U13.1 (rt)
unnamed: C14.1, FB4.2, U14.3 (EN), U14.4 (Vin)
unnamed: C16.1, U14.1 (filter)
unnamed: R21.1, R59.2, R60.2, R61.1, U15.2 (fb)
unnamed: C68.1, R64.1, USB1.MP (CASE)
unnamed: ESD1.1 (K1), ESD1.10 (K1), R62.1, USB1.A5 (CC1)
unnamed: ESD1.5 (K4), ESD1.6 (K4), R63.1, USB1.B5 (CC2)
unnamed: USB1.A4 (VBUS), USB1.B4 (VBUS)
unnamed: PC1.1, PR1.2, PR22.1, pump1.1
unnamed: PC2.1, PC11.2, PR2.2, PR20.2, PR23.1, pump1.2
